janniklangfeld-del/wordclock/docs/hardware/zuschnitt_leiste.pdf

# Rahmenleiste Buche – Zuschnitt mit 45°-Gehrung · 4 Stück

Wordclock · Holzrahmen · Maße in mm · Stand 12.11.2026

## A · Sichtseite von vorn (18 mm breit)

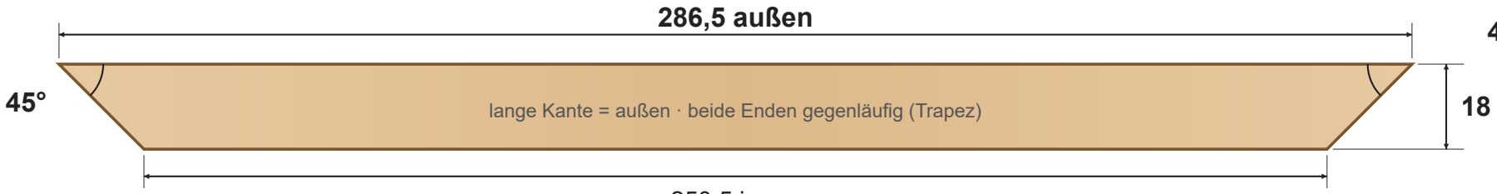
[picture p6: figure]
286,5 außen

### 250,5 innen

45°

lange Kante = außen · beide Enden gegenläufig (Trapez)

## B · Außenseite (50 mm hoch)

### Gehrungsschnitt geht senkrecht durch die volle Breite 50 mm

gestrichelt: Innenkante 250,5 (verdeckt)

50

## Querschnitt

1:1 · ▲ vorn

18

5

0

## 4 Leisten ergeben den Rahmen Bitte zuschneiden – 4 Stück, alle exakt gleich

- Buche-Leimholz 18 mm, Streifen 50 mm breit (Art.-Nr. 14455864) - Länge außen 286,5 (lange Kante), innen 250,5 - beide Enden 45° Gehrung, gegenläufig → Trapez - Gehrung über die 18 mm, Schnitt durch die vollen 50 mm - alle 4 auf ± 0,5 mm gleich lang (sonst klafft eine Ecke) - dazu 1 Streifen 50 × 300 gerade als Probestück

Kappsäge: hochkant (50 senkrecht), Drehteller 45° – braucht 50 mm Schnitthöhe;
oder flach auf der 50er-Seite, Sägeblatt 45° geneigt (Schnitthöhe 18 mm).

Falls keine Gehrung möglich: 5 Streifen 50 × 300 gerade – die Gehrung säge ich selbst.

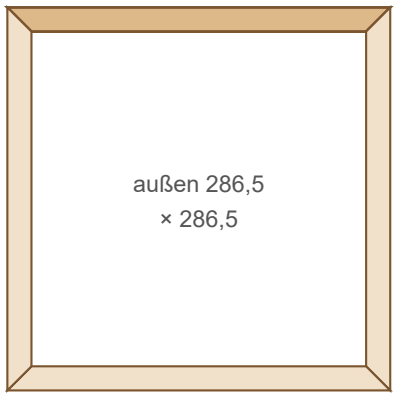
[picture p7: figure]
außen 286,5 × 286,5

Maß gilt für eine Front von 250,0 mm (+ 0,5 Luft). Vorher Front messen: Länge außen = Front + 36,5.
