janniklangfeld-del/wordclock/docs/hardware/loetvorlage_start_oben_links.pdf

E 0 1 | S 2 3 | K 4 5 | I 6 7 | S 8 9 | T 10 | 11
Z 43 42 | E 41 40 | H 39 38 | N 37 36 | Z 35 34 | W 33 | 32
D 44 45 | R 46 47 | E 48 49 | I 50 51 | V 52 53 | 54 | I 55
V 87 86 | O 85 84 | R 83 82 | F 81 80 | U 79 78 | N 77 | 76
H 88 89 | A 90 91 | L 92 93 | B 94 95 | A 96 97 | E 98 | 99
E 131 130 | I 129 128 | N 127 126 | S 125 124 | X 123 122 | A 121 | 120
D 132 133 | R 134 135 | E 136 137 | I 138 139 | P 140 141 | M 142 | 143
S 175 174 | E 173 172 | C 171 170 | H 169 168 | S 167 166 | N 165 | 164
S 176 177 | I 178 179 | E 180 181 | B 182 183 | E 184 185 | N 186 | 187
Z 219 218 | E 217 216 | H 215 214 | N 213 212 | E 211 210 | U 209 | 208

## Reihe 1

## Reihe 2

## Reihe 3

## Reihe 4

## Reihe 5

## Reihe 6

## Reihe 7

## Reihe 8

## Reihe 9

## Reihe 10

220 | 221 | 222

## Minutenpunkte (4 LEDs am Stück)

## Daten rein (DIN) + LED 0

E1

E3

# Lötvorlage Wordclock 1:1 – Start oben links

Blatt 1 von 2 (linke Hälfte) · Blick auf die LED-Seite = Vorderansicht der Uhr (nicht gespiegelt)

100 mm
Kontrolle: Der Balken muss genau 100 mm lang sein. Sonst mit "Tatsächliche Größe" (100 %) drucken.

Rot gestrichelt = Schnittlinie · Dreieck = Datenrichtung (Pfeil auf dem Streifen) · Schwarze Linie = Verbinder +5 V / Daten / GND E1–E3 = zusätzliche Einspeisung (nur +5 V und GND) · Blätter an der Klebelinie mit den Kreuzen deckungsgleich übereinanderlegen

I

6 | 7
S 8 9 | T 10 | 11 | L 12 13 | F 14 15 | Ü 16 17 | N 18 19 | F 20 21
Z 35 34 | W 33 | 32 | A 31 30 | N 29 28 | Z 27 26 | I 25 24 | G 23 22
V 52 53 | 54 | I 55 | E 56 57 | R 58 59 | T 60 61 | E 62 63 | L 64 65
U 79 78 | N 77 | 76 | K 75 74 | N 73 72 | A 71 70 | C 69 68 | H 67 66
A 96 97 | E 98 | 99 | L 100 101 | F 102 103 | Ü 104 105 | N 106 107 | F 108 109
X 123 122 | A 121 | 120 | M 119 118 | Z 117 116 | W 115 114 | E 113 112 | I 111 110
P 140 141 | M 142 | 143 | J 144 145 | V 146 147 | I 148 149 | E 150 151 | R 152 153
S 167 166 | N 165 | 164 | L 163 162 | A 161 160 | C 159 158 | H 157 156 | T 155 154
E 184 185 | N 186 | 187 | Z 188 189 | W 190 191 | Ö 192 193 | L 194 195 | F 196 197
E 211 210 | U 209 | 208 | N 207 206 | K 205 204 | U 203 202 | H 201 200 | R 199 198

## Reihe 1

N

37 | 36

## Reihe 2

I

50 | 51

## Reihe 3

F

81 | 80

## Reihe 4

B

94 | 95

## Reihe 5

S

125 | 124

## Reihe 6

I

138 | 139

## Reihe 7

H

169 | 168

## Reihe 8

B

182 | 183

## Reihe 9

N

213 | 212

## Reihe 10

220 | 221 | 222 | 223

## Minutenpunkte (4 LEDs am Stück)

E2

# Lötvorlage Wordclock 1:1 – Start oben links

Blatt 2 von 2 (rechte Hälfte) · Blick auf die LED-Seite = Vorderansicht der Uhr (nicht gespiegelt)

100 mm
Kontrolle: Der Balken muss genau 100 mm lang sein. Sonst mit "Tatsächliche Größe" (100 %) drucken.

Rot gestrichelt = Schnittlinie · Dreieck = Datenrichtung (Pfeil auf dem Streifen) · Schwarze Linie = Verbinder +5 V / Daten / GND E1–E3 = zusätzliche Einspeisung (nur +5 V und GND) · Blätter an der Klebelinie mit den Kreuzen deckungsgleich übereinanderlegen
