janniklangfeld-del/wordclock/docs/hardware/loetvorlage_start_oben_rechts.pdf

E 21 20 | S 19 18 | K 17 16 | I 15 14 | S 13 12 | T 11 | 10
Z 22 23 | E 24 25 | H 26 27 | N 28 29 | Z 30 31 | W 32 | 33
D 65 64 | R 63 62 | E 61 60 | I 59 58 | V 57 56 | 55 | I 54
V 66 67 | O 68 69 | R 70 71 | F 72 73 | U 74 75 | N 76 | 77
H 109 108 | A 107 106 | L 105 104 | B 103 102 | A 101 100 | E 99 | 98
E 110 111 | I 112 113 | N 114 115 | S 116 117 | X 118 119 | A 120 | 121
D 153 152 | R 151 150 | E 149 148 | I 147 146 | P 145 144 | M 143 | 142
S 154 155 | E 156 157 | C 158 159 | H 160 161 | S 162 163 | N 164 | 165
S 197 196 | I 195 194 | E 193 192 | B 191 190 | E 189 188 | N 187 | 186
Z 198 199 | E 200 201 | H 202 203 | N 204 205 | E 206 207 | U 208 | 209

## Reihe 1

## Reihe 2

## Reihe 3

## Reihe 4

## Reihe 5

## Reihe 6

## Reihe 7

## Reihe 8

## Reihe 9

## Reihe 10

223 | 222 | 221

## Minutenpunkte (4 LEDs am Stück)

E2

# Lötvorlage Wordclock 1:1 – Start oben rechts

Blatt 1 von 2 (linke Hälfte) · Blick auf die LED-Seite = Vorderansicht der Uhr (nicht gespiegelt)

100 mm
Kontrolle: Der Balken muss genau 100 mm lang sein. Sonst mit "Tatsächliche Größe" (100 %) drucken.

Rot gestrichelt = Schnittlinie · Dreieck = Datenrichtung (Pfeil auf dem Streifen) · Schwarze Linie = Verbinder +5 V / Daten / GND E1–E3 = zusätzliche Einspeisung (nur +5 V und GND) · Blätter an der Klebelinie mit den Kreuzen deckungsgleich übereinanderlegen

I

15 | 14
S 13 12 | T 11 | 10 | L 9 8 | F 7 6 | Ü 5 4 | N 3 2 | F 1 0
Z 30 31 | W 32 | 33 | A 34 35 | N 36 37 | Z 38 39 | I 40 41 | G 42 43
V 57 56 | 55 | I 54 | E 53 52 | R 51 50 | T 49 48 | E 47 46 | L 45 44
U 74 75 | N 76 | 77 | K 78 79 | N 80 81 | A 82 83 | C 84 85 | H 86 87
A 101 100 | E 99 | 98 | L 97 96 | F 95 94 | Ü 93 92 | N 91 90 | F 89 88
X 118 119 | A 120 | 121 | M 122 123 | Z 124 125 | W 126 127 | E 128 129 | I 130 131
P 145 144 | M 143 | 142 | J 141 140 | V 139 138 | I 137 136 | E 135 134 | R 133 132
S 162 163 | N 164 | 165 | L 166 167 | A 168 169 | C 170 171 | H 172 173 | T 174 175
E 189 188 | N 187 | 186 | Z 185 184 | W 183 182 | Ö 181 180 | L 179 178 | F 177 176
E 206 207 | U 208 | 209 | N 210 211 | K 212 213 | U 214 215 | H 216 217 | R 218 219

## Reihe 1

N

28 | 29

## Reihe 2

I

59 | 58

## Reihe 3

F

72 | 73

## Reihe 4

B

103 | 102

## Reihe 5

S

116 | 117

## Reihe 6

I

147 | 146

## Reihe 7

H

160 | 161

## Reihe 8

B

191 | 190

## Reihe 9

N

204 | 205

## Reihe 10

223 | 222 | 221 | 220

## Minutenpunkte (4 LEDs am Stück)

## Daten rein (DIN) + LED 0

E1

E3

# Lötvorlage Wordclock 1:1 – Start oben rechts

Blatt 2 von 2 (rechte Hälfte) · Blick auf die LED-Seite = Vorderansicht der Uhr (nicht gespiegelt)

100 mm
Kontrolle: Der Balken muss genau 100 mm lang sein. Sonst mit "Tatsächliche Größe" (100 %) drucken.

Rot gestrichelt = Schnittlinie · Dreieck = Datenrichtung (Pfeil auf dem Streifen) · Schwarze Linie = Verbinder +5 V / Daten / GND E1–E3 = zusätzliche Einspeisung (nur +5 V und GND) · Blätter an der Klebelinie mit den Kreuzen deckungsgleich übereinanderlegen
