janniklangfeld-del/wordclock/cad/referenzbilder/rahmenvergleich.png

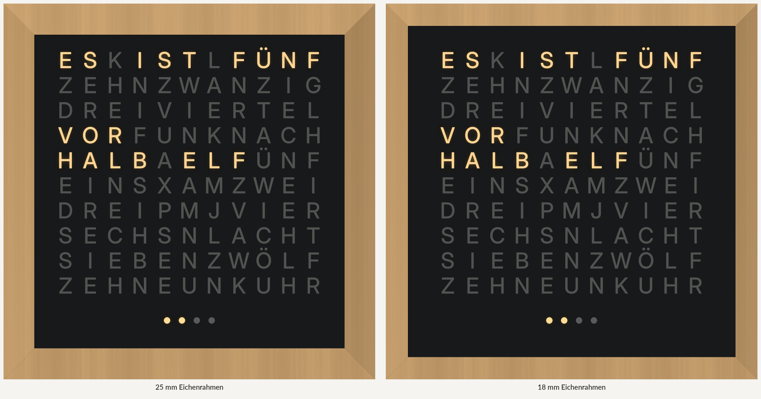
cad/referenzbilder/rahmenvergleich.png
