janniklangfeld-del/wordclock/cad/referenzbilder/wordclock_massplan.png

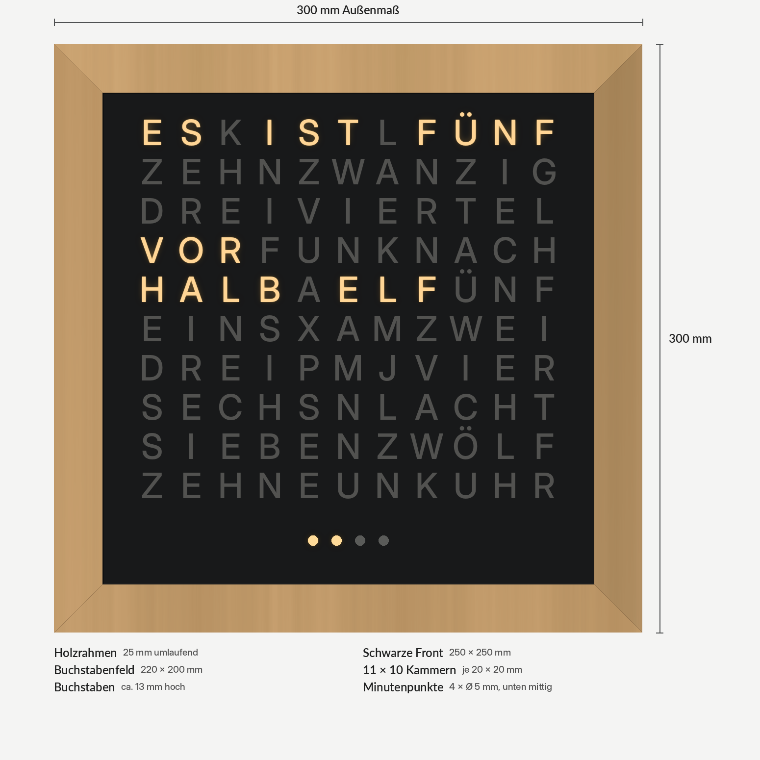
cad/referenzbilder/wordclock_massplan.png
