janniklangfeld-del/wordclock/cad/referenzbilder/wordclock_mockup_30x30.png

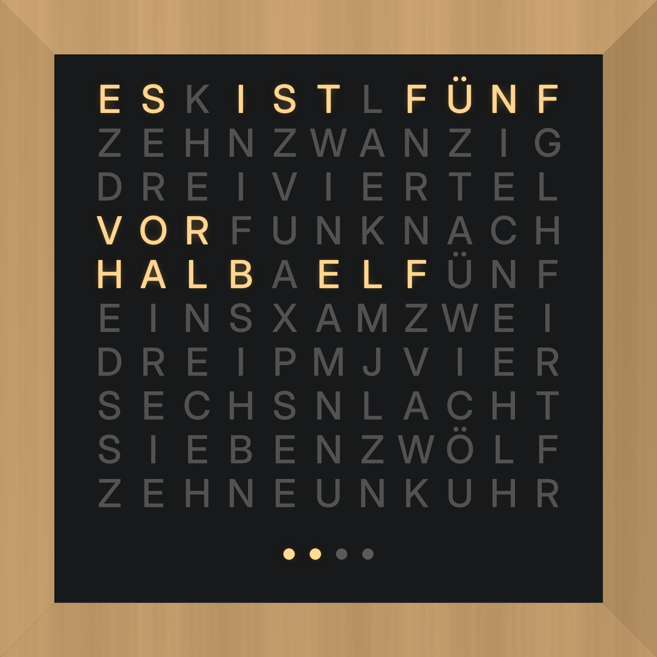
cad/referenzbilder/wordclock_mockup_30x30.png
