janniklangfeld-del/wordclock/docs/hardware/uebersicht_front_querschnitt.png

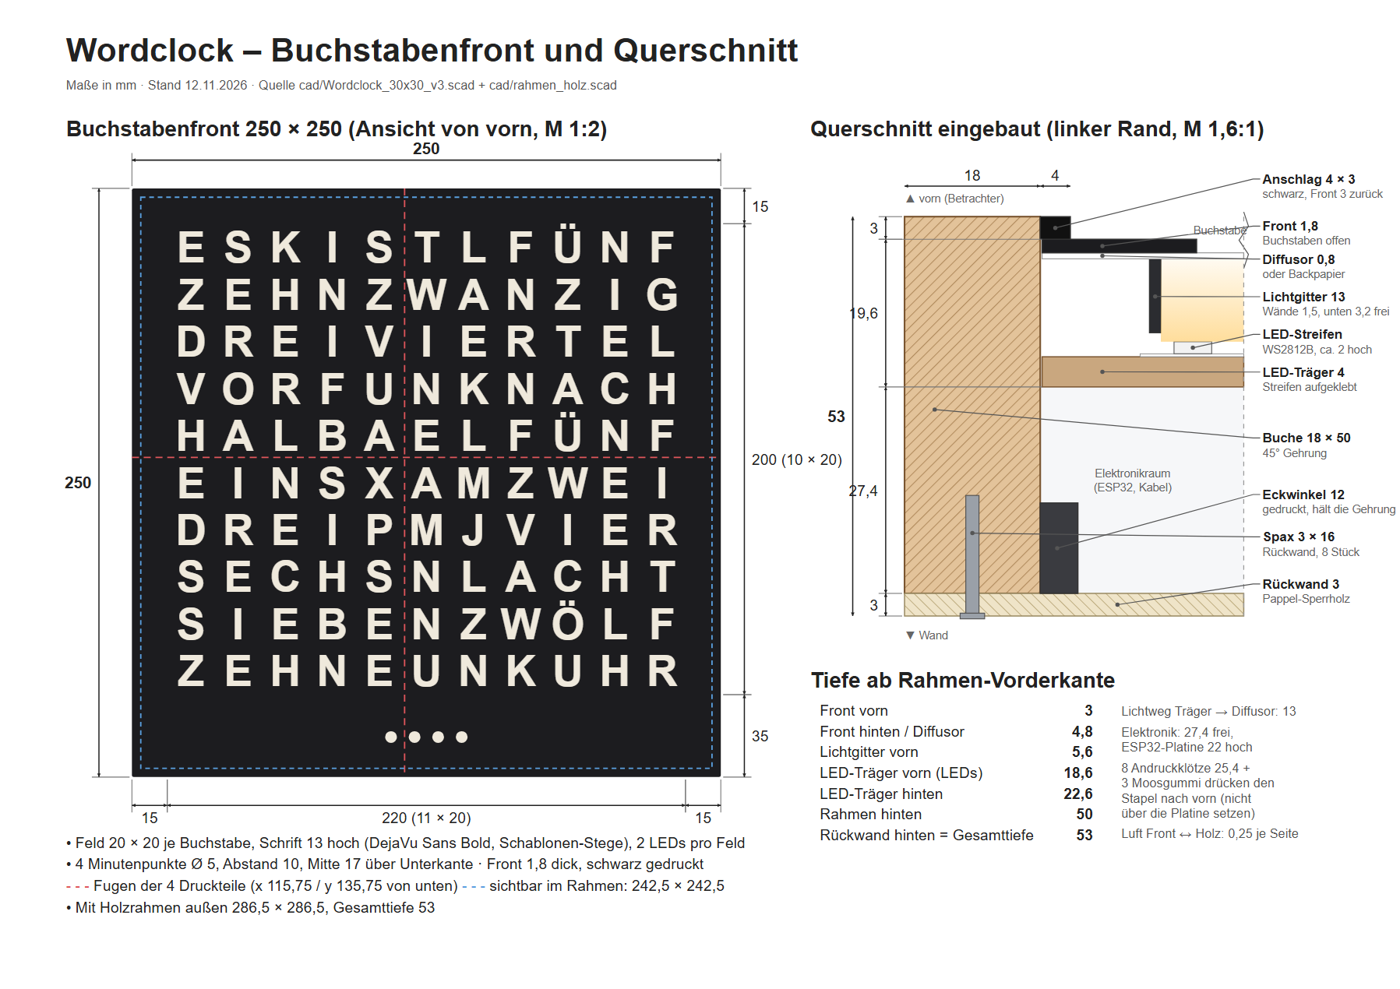
docs/hardware/uebersicht_front_querschnitt.png
