janniklangfeld-del/wordclock/docs/hardware/zuschnitt_leiste.png

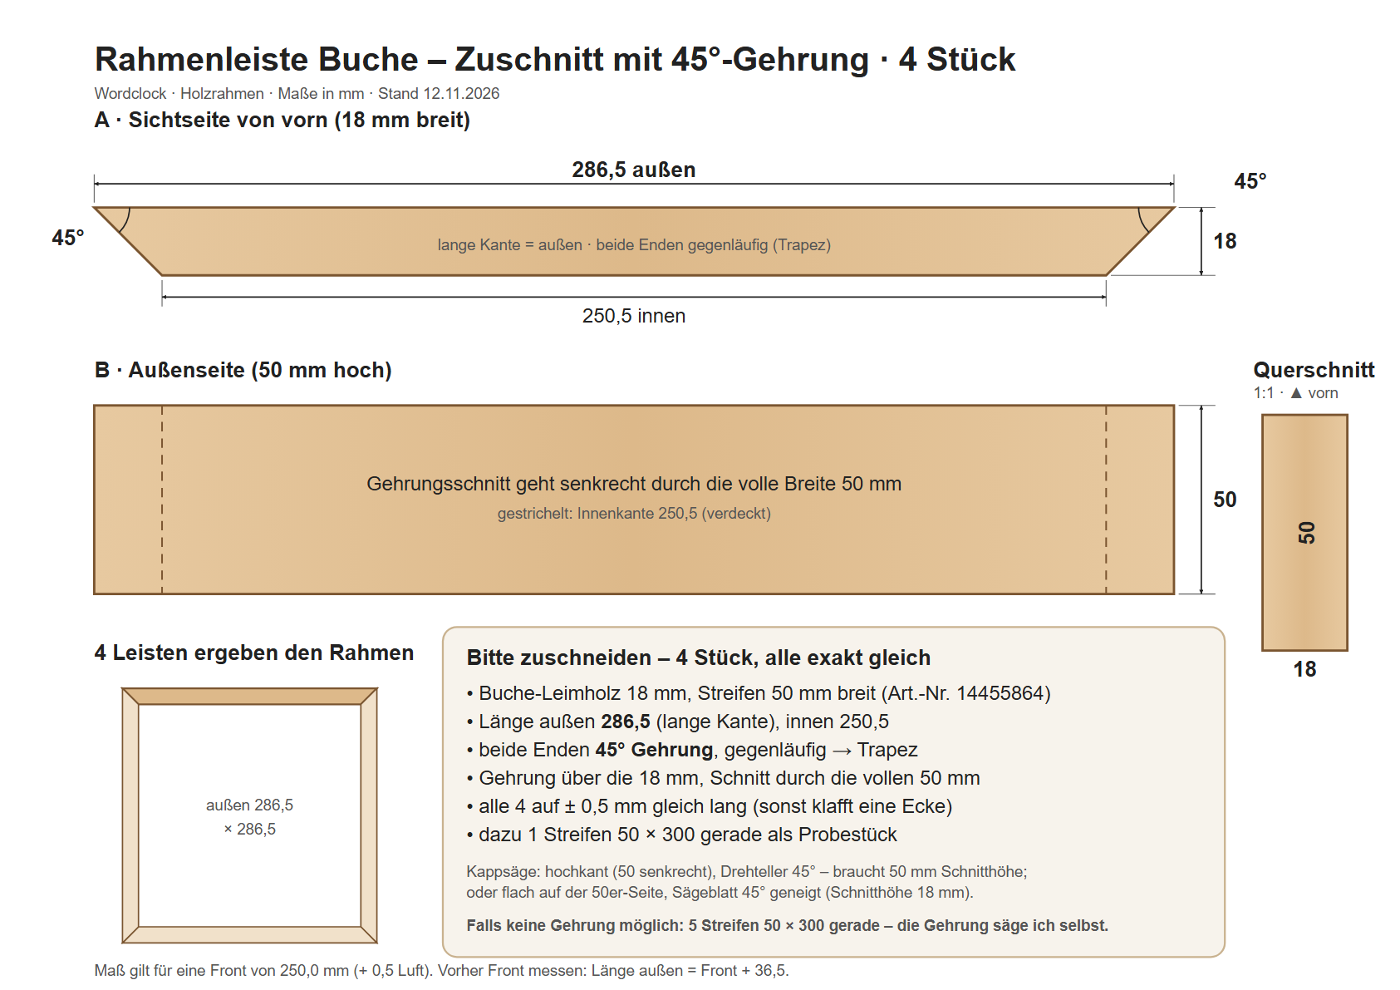
docs/hardware/zuschnitt_leiste.png
