janniklangfeld-del/wordclock/web/maja.jpg

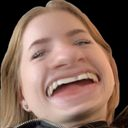
web/maja.jpg
