janniklangfeld-del/wordclock/cad/stl/lichtgitter_TR.stl

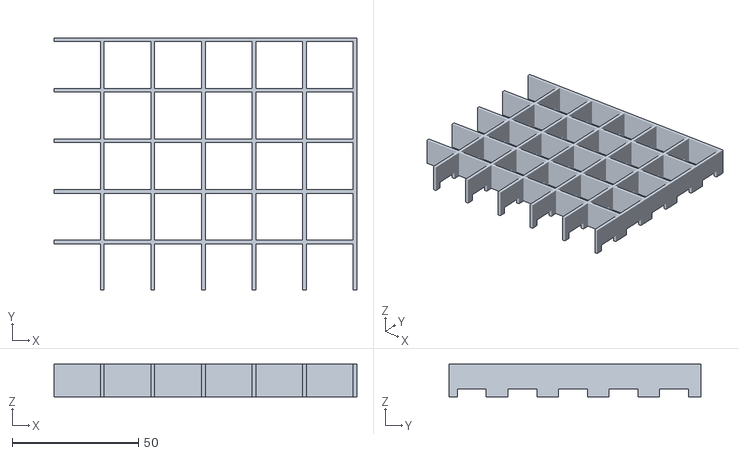
[picture p14: CAD file, 2026-11-10]
cad/stl/lichtgitter_TR.stl
119.9 x 99.9 x 13.0
