janniklangfeld-del/wordclock/cad/stl/diffusor_BR_v3.stl

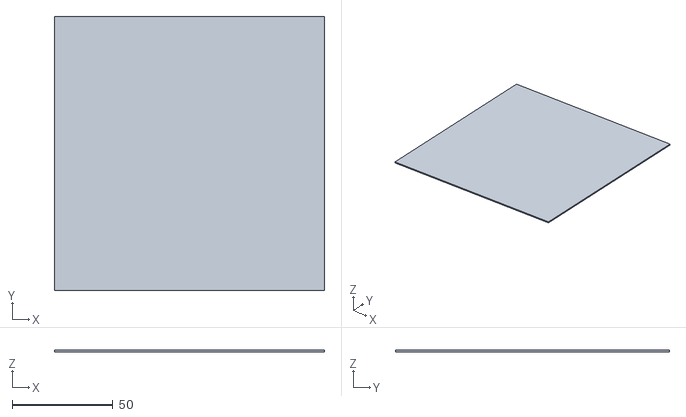
[picture p15: CAD file, 2026-11-10]
cad/stl/diffusor_BR_v3.stl
134.1 x 135.9 x 0.8
