janniklangfeld-del/wordclock/cad/stl/lichtgitter_BR_v3.stl

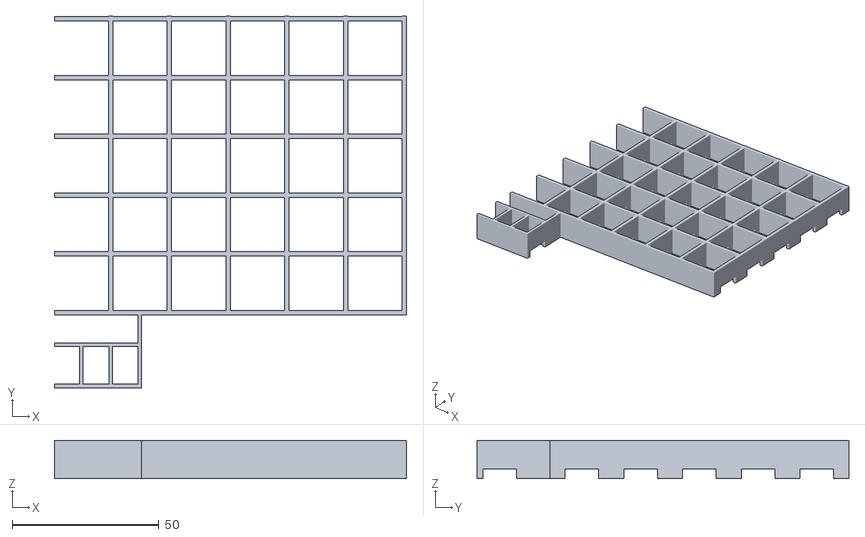
[picture p16: CAD file, 2026-11-10]
cad/stl/lichtgitter_BR_v3.stl
119.9 x 126.5 x 13.0
