janniklangfeld-del/wordclock/cad/stl/lichtgitter_TL.stl

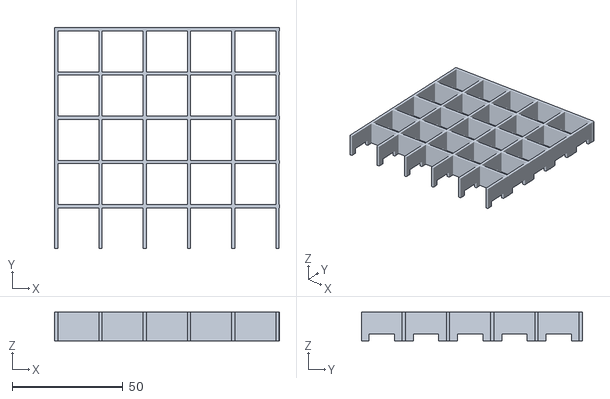
[picture p17: CAD file, 2026-11-10]
cad/stl/lichtgitter_TL.stl
101.7 x 99.9 x 13.0
