janniklangfeld-del/wordclock/cad/stl/lichtgitter_BL.stl

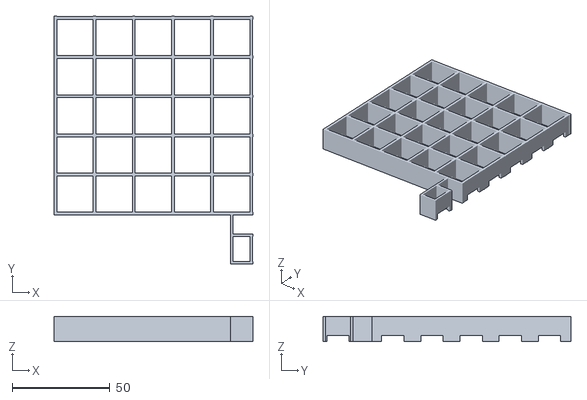
[picture p18: CAD file, 2026-11-10]
cad/stl/lichtgitter_BL.stl
101.7 x 126.5 x 13.0
