janniklangfeld-del/wordclock/cad/stl/front_BR_v3.stl

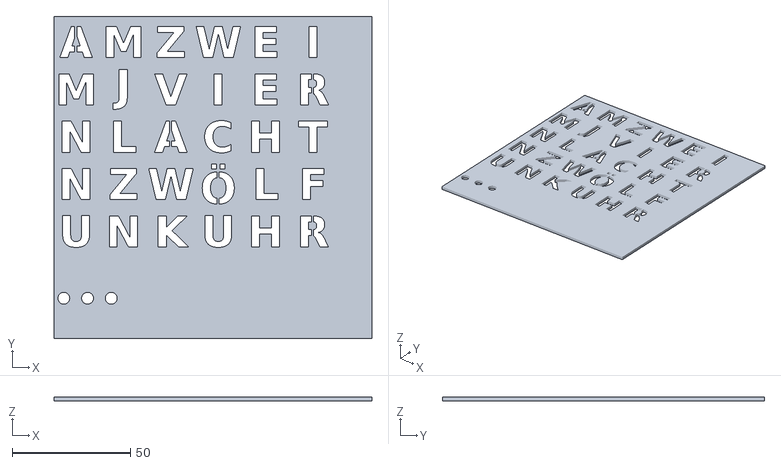
[picture p19: CAD file, 2026-11-10]
cad/stl/front_BR_v3.stl
134.1 x 135.9 x 1.80
