janniklangfeld-del/wordclock/docs/hardware/uebersicht_front_querschnitt.pdf

# Wordclock – Buchstabenfront und Querschnitt

## Buchstabenfront 250 × 250 (Ansicht von vorn, M 1:2)

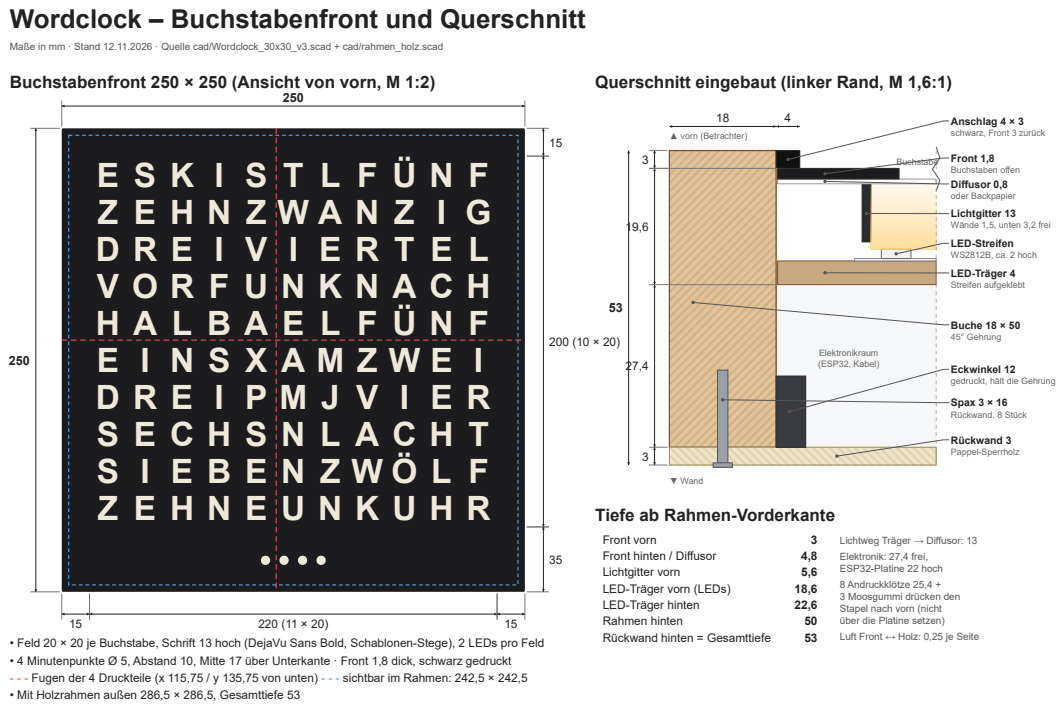
[picture p20: page 1]
▲ vorn (Betrachter); ▼ Wand; Elektronikraum (ESP32, Kabel); Buchstabe; Anschlag 4 × 3; Rückwand 3 Pappel-Sperrholz; Buche 18 × 50 45° Gehrung; Front vorn; Front hinten / Diffusor; Lichtgitter vorn; LED-Träger vorn (LEDs); LED-Träger hinten; Rahmen hinten; Rückwand hinten = Gesamttiefe

Maße in mm · Stand 12.11.2026 · Quelle cad/Wordclock_30x30_v3.scad + cad/rahmen_holz.scad

Querschnitt eingebaut (linker Rand, M 1,6:1)

schwarz, Front 3 zurück

Front 1,8
Buchstaben offen
Diffusor 0,8
oder Backpapier
Lichtgitter 13
Wände 1,5, unten 3,2 frei
LED-Streifen
WS2812B, ca. 2 hoch
LED-Träger 4
Streifen aufgeklebt

Eckwinkel 12
gedruckt, hält die Gehrung
Spax 3 × 16
Rückwand, 8 Stück

Tiefe ab Rahmen-Vorderkante

Lichtweg Träger → Diffusor: 13
Elektronik: 27,4 frei,
ESP32-Platine 22 hoch
8 Andruckklötze 25,4 +
3 Moosgummi drücken den
Stapel nach vorn (nicht
über die Platine setzen)
Luft Front ↔ Holz: 0,25 je Seite

• Feld 20 × 20 je Buchstabe, Schrift 13 hoch (DejaVu Sans Bold, Schablonen-Stege), 2 LEDs pro Feld
• 4 Minutenpunkte Ø 5, Abstand 10, Mitte 17 über Unterkante · Front 1,8 dick, schwarz gedruckt
- - - Fugen der 4 Druckteile (x 115,75 / y 135,75 von unten) - - - sichtbar im Rahmen: 242,5 × 242,5
• Mit Holzrahmen außen 286,5 × 286,5, Gesamttiefe 53
