janniklangfeld-del/wordclock/src/app/main.cpp

// Majas Wordclock – Hauptfirmware
//
// Deutsche Wortuhr (11 x 10 Buchstaben, 4 Minutenpunkte) mit Weboberflaeche,
// Live-3D-Ansicht, Effekten, Alexa (Hue-Emulation), optionalem Helligkeitssensor
// und Updates ueber GitHub Releases. Ueberblick: docs/SOFTWARE.md

#include <Arduino.h>
#include "alexa.h"
#include "app.h"
#include "display.h"
#include "games.h"
#include "light.h"
#include "net.h"
#include "ota.h"
#include "settings.h"
#include "sys.h"
#include "web.h"

namespace app {
void settingsChanged(uint32_t flags, Source src) {
  if (!flags) return;
  settings.requestSave();
  if (flags & CH_TIME) net::applyTimeConfig();
  if (flags & CH_DISPLAY) {
    display::settingsChanged();
    if (src != SRC_ALEXA) alexa::sync();
  }
  web::notifySettings();
}
}  // namespace app

void setup() {
  web::lock();  // gemeinsame Daten gehoeren der Hauptschleife (siehe web.cpp)
  Serial.begin(115200);
  delay(200);
  Serial.printf("\n=== Majas Wordclock %s (Repo: %s) ===\n", FW_VERSION, GITHUB_REPO);

  sys::begin();  // Neustart-Grund merken, Wachhund an
  settings.load();
  display::begin();
  display::setState(SysState::Booting);
  display::loop();
  light::begin();
  games::begin();

  // Begruessung abspielen, bevor der (bis zu 20 s blockierende) WLAN-Aufbau startet
  while (display::introRunning()) {
    display::loop();
    sys::feed();
    delay(1);
  }

  net::begin();
  ota::begin();
  web::unlock();
}

void loop() {
  sys::feed();
  web::lock();
  net::loop();
  web::loop();
  alexa::loop();
  ota::loop();
  games::loop();
  if (!games::busy()) {  // im Spiel nichts Blockierendes (Lichtsensor, Flash schreiben)
    light::loop();
    settings.loop();
  }
  display::loop();
  web::unlock();
  delay(1);  // hier kommen Web-Anfragen an die Reihe
}
