janniklangfeld-del/wordclock/(commit log)

2026-11-10 Projektstruktur, LED-Test und Uhr-Grundgeruest mit OTA
    [Wordclock_30x30_v3.scad, diffusor_BR_v3.stl, front_BR_v3.stl, lichtgitter_BL.stl, lichtgitter_BR_v3.stl, lichtgitter_TL.stl, lichtgitter_TR.stl]
2026-11-10 CLAUDE.md: Stand nach erstem Build und Repo-Anlage
2026-11-10 Hardware: Pin 6 des 74AHCT125 liegt im Aufbau auf GND (unkritisch)
2026-11-10 Hardware: Herstellerkarte des LED-Streifens (Stecker, Einspeisung)
2026-11-10 CLAUDE.md: LED-Test geflasht (COM7, CP2102)
2026-11-10 LED-Test: Pin-Messmodus (d); Doku: ohne Netzteil bleibt alles dunkel
2026-11-10 Doku: LED-Test mit Streifen 1 erfolgreich
2026-11-10 Hardware: Plan fuer Einspeisung an 3 Punkten, Test mit 224 LEDs
2026-11-10 Loetvorlage 1:1 fuer die LED-Streifen (Start oben links/rechts)
2026-11-10 PDF/Bilder/STL als binaer markieren, Python-Cache entfernen
2026-11-10 Stand: Uhr-Firmware auf ESP32 geflasht, Portal aktiv
2026-11-11 Versteckter LED-Testmodus auf der Webseite
    Lauflicht, Reihen, Buchstaben, RGBW, alle an, Einzel-LED, Minutenpunkte.
    Freischalten: 5x auf das Herz im Fuss tippen oder #test.
2026-11-11 Stand: Begruessung auf LEDs noch ungetestet
2026-11-11 Stand: WLAN-Update ueber Webseite getestet, ArduinoOTA an Firewall gescheitert
2026-11-11 Stand: erstes Release v1.0.0 auf der Uhr, GitHub erreichbar
2026-11-11 Stand korrigiert: Begruessungstext auf der Uhr noch nicht umgestellt
2026-11-11 Rahmen Variante 1: Bauplan (SVG) und OpenSCAD-Modell
    [rahmen_variante1.scad]
2026-11-11 Webseite: Majas Foto statt W als Logo und Favicon
2026-11-12 Holzrahmen Buche: 3D-Modell, Bauplan und Bauhaus-Einkaufsliste
    [rahmen_holz.scad]
2026-11-12 Anleitung: Fernzugriff per WireGuard-VPN der FRITZ!Box
2026-11-12 Holzrahmen: 50 mm tief fuer 22 mm hohe ESP32-Platine (Buche-Leimholz 18 x 50)
    [rahmen_holz.scad]
2026-11-12 Uebersicht Buchstabenfront und Querschnitt der eingebauten Uhr
2026-11-13 MJ Arcade: Spiele auf der Uhr mit Handy-Controller, Fotos auf der Uhr
    6 Spiele (Snake, Tetris 1P/2P/Bot, Pong, Lichtrenner, Vier gewinnt,
    Reaktion), Lobby/Countdown/Pause/Statistik/Rekorde, binaere Tasten
    ueber WebSocket, WLAN-Sleep aus und Hintergrundarbeit pausiert im
    Spiel. Spiele-Knopf unten rechts. Fotos liegen nur im LittleFS der
    Uhr (private/fotos ist gitignored).
2026-11-13 Arcade-Fixes: Spielnachrichten kamen nie an, Uhr hing bei schwachem WLAN
    - Webseite rief arcOnOpen/arcOnGame statt arOnOpen/arOnGame auf -> Lobby
    und Controller erschienen nie (Knoepfe ohne Wirkung)
    - Live-Bild nur bei Aenderung (sonst 1/s), langsame Handys gebremst,
    bei Sendefehler getrennt; WEBSOCKETS_TCP_TIMEOUT 800 ms statt 5 s
    - WLAN-Stromsparen dauerhaft aus
    - Lobby ohne verbundene Spieler schliesst nach 30 s
    - Gleicher Name uebernimmt seinen Platz (zweiter Tab / anderes Handy)
    - Hinweis 'Keine Live-Verbindung' statt stummer Knoepfe
    [games.cpp, net.cpp, web.cpp]
2026-11-13 Stand: 1.1.2 mit MJ Arcade auf der Uhr
2026-11-13 Mehrere Handys: Platz nur per Geraete-Kennung uebernehmen, 8 Clients, QR-Einladung
    - Gleicher Name (Standard 'MJ' auf jedem Handy) nahm dem anderen den Platz weg
    -> Uebernahme nur noch mit derselben Geraete-Kennung, zweiter Name wird 'MJ 2'
    - bis 8 WebSocket-Clients (vorher 5), schnellerer Heartbeat raeumt Leichen ab
    - Live-Bild max. 10/s und aus, solange die Spielhalle offen ist
    - Lobby: 'Mitspieler einladen' mit QR-Code und IP-Adresse (Android kann .local nicht)
2026-11-13 Stand: 1.1.3 mit Mehrspieler-Fixes auf der Uhr
2026-11-13 Live-Verbindungen: immer einen Platz frei halten, Anzeige wer verbunden ist
    - Sind fast alle 8 Plaetze belegt, fliegt die Verbindung raus, die am
    laengsten still ist (vergessene Tabs); sichtbare Seiten senden alle 5 s 'hb'
    - Neu-Verbinden mit wachsender, zufaelliger Pause, nicht aus dem Hintergrund,
    nie zwei Verbindungen pro Seite
    - System -> Info zeigt alle Live-Verbindungen mit IP
2026-11-13 Wachhund gegen Haenger (60 s, pausiert bei Updates) und Neustart-Grund in der Info
    Bleibt die Uhr z. B. mitten in der Begruessung stehen, startet sie nach 60 s
    neu. System -> Info zeigt den Grund des letzten Neustarts (Strom, Absturz,
    Wachhund, Spannungseinbruch) und zaehlt unerwartete Neustarts.
2026-11-13 Begruessung: weich in die Uhrzeit einblenden statt gruene Punkte und Sprung
    - nach der Begruessung bleibt die Uhr dunkel, bis die Internetzeit da ist
    (max. 60 s; Portal/Fehler weiter sichtbar)
    - Uebergaenge zaehlen pro Bild max. 40 ms weiter: haengt die Schleife kurz,
    pausiert der Uebergang statt aufs Ende zu springen
2026-11-13 Mehrspieler: Verbindungen nicht mehr faelschlich als getrennt werten (ESP32-Core-Bug)
    WiFiClient::connected() prueft mit recv(len 0); liegen Daten an, setzt lwIP
    errno nicht und connected() wertet einen alten Fehlercode aus. Nach einem
    Fehler auf irgendeiner Verbindung (Handy schliesst Seite) wurden neue
    Mitspieler im Handshake stumm abgewiesen und laufende Spieler getrennt.
    lwip_recv wird per Linker umgeleitet und loescht errno vorher.
2026-11-13 Arcade: Highscore nach jedem Spiel, lueckenlose Tastenfelder, Wischen fuer Snake/T.R.O.N
    - Ergebnis zeigt Rekord, wer ihn haelt und wie viel gefehlt hat (alle Spieler,
    auch zu zweit); Spiele zu zweit zusaetzlich 'Meiste Siege' mit Abstand
    - Tastenfeld fuellt die unteren 3/4 ohne tote Stellen (Abstand = Rand der Taste)
    - Snake/T.R.O.N: Steuerkreuz als vier Dreiecke, Steuerung Beides/Druecken/Wischen
    - Lichtrenner heisst jetzt T.R.O.N
2026-11-13 Arcade: Flatterherz, Knopf 'Zur Uhr', Ergebnis nach 15 s zurueck zur Uhrzeit
    - Neues Spiel Flatterherz (allein / zu zweit gleichzeitig): tippen = flattern,
    durch die Luecken fliegen, Highscore in Luecken
    - Ergebnis-Bildschirm: 15 s ohne Aktion -> Uhr zeigt wieder die Uhrzeit,
    Handys schliessen die Spielhalle
    - Uhr-Knopf ueber dem Spiele-Knopf: beendet jedes Spiel (g.home), Effekt/
    Laufschrift -> Uhrzeit, Uhr an
2026-11-13 Reaktion: Loslassen messen statt Tippen, Zeit nach jeder Runde auf dem Handy
    Alle halten den Knopf gedrueckt, nach zufaelliger Wartezeit wird die Uhr gruen,
    wer schneller loslaesst gewinnt. Zu frueh loslassen verliert die Runde. Jeder
    Spieler wird gemessen; das Handy zeigt Anleitung und Zeiten direkt auf dem Knopf.
2026-11-13 Arcade: 6 neue Spiele, kein Doppeltipp-Zoom, Live-Zeile wieder aktuell
    - Wortblitz (Buchstaben blitzen im Raster der Uhr auf, 4 Woerter zur Wahl)
    - Tauziehen (Tippen um die Wette, auch gegen MJ-Bot)
    - Seeschlacht (5x5, eigene Flotte nur auf dem eigenen Handy, auch gegen Bot)
    - Herzregen, Mauerbrecher, Huerdenlauf (zu zweit auf zwei Bahnen)
    - Engine: Eingaben mit Daten (g.in) und private Daten pro Handy (me)
    - Spielhalle: Doppeltipp zoomt auf iPhones nicht mehr
    - Fix: serializeJson ueberschreibt Strings -> Live-Zeile/Punktestand kam seit
    1.2.0 bei Spielen ohne Zusatzdaten nicht mehr aufs Handy
    [games.cpp, games_internal.h, games_list.cpp, games_more.cpp, games_more2.cpp]
2026-11-13 Pong: Aufschlag gerade und langsamer, danach normales Tempo
2026-11-14 Helligkeitsregler wirkt auch im Nachtmodus, Hinweis nicht mehr hinter der Uhr
2026-11-14 Webserver: leere Safari-Vorratsverbindungen blockieren die Seite nicht mehr
2026-11-14 Webserver asynchron: Seite und Mehrspieler zuverlaessig, alles auf Port 80
    Der alte WebServer + WebSockets-Server lief in der Hauptschleife und wartete
    auf langsame Handys - am iPhone mal keine Verbindung, mal endloses Laden.
    Jetzt ESPAsyncWebServer im eigenen Task, WebSocket unter /ws, Hauptschleife
    haelt eine Sperre, WebSocket-Ereignisse kommen ueber eine Warteschlange.
    PoolServer, netfix.cpp (lwip_recv-Wrap) und die WebSockets-Lib entfallen.
    Auf der 3D-Uhr wird nur noch gedreht, nicht mehr gescrollt.
2026-11-14 Doku: Fernzugriff per WireGuard eingerichtet
